JefferyLim/floppy/finalReport/images/BOT.jpg

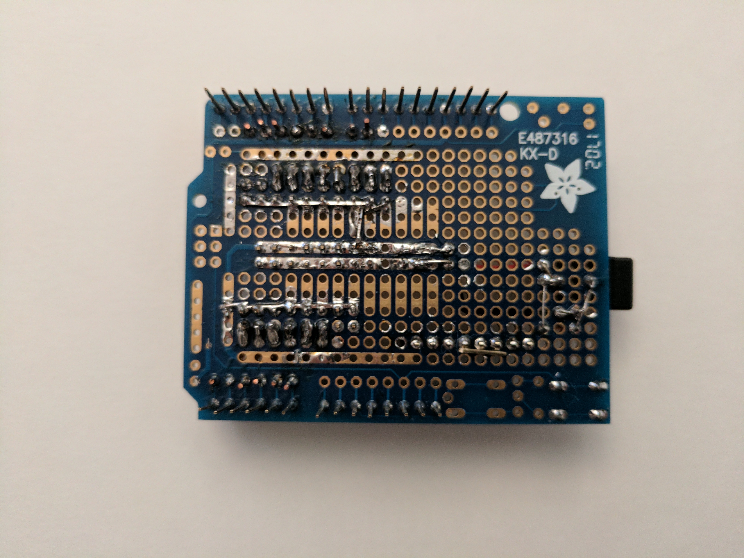
finalReport/images/BOT.jpg
