JefferyLim/floppy/finalReport/images/power_wire.jpg

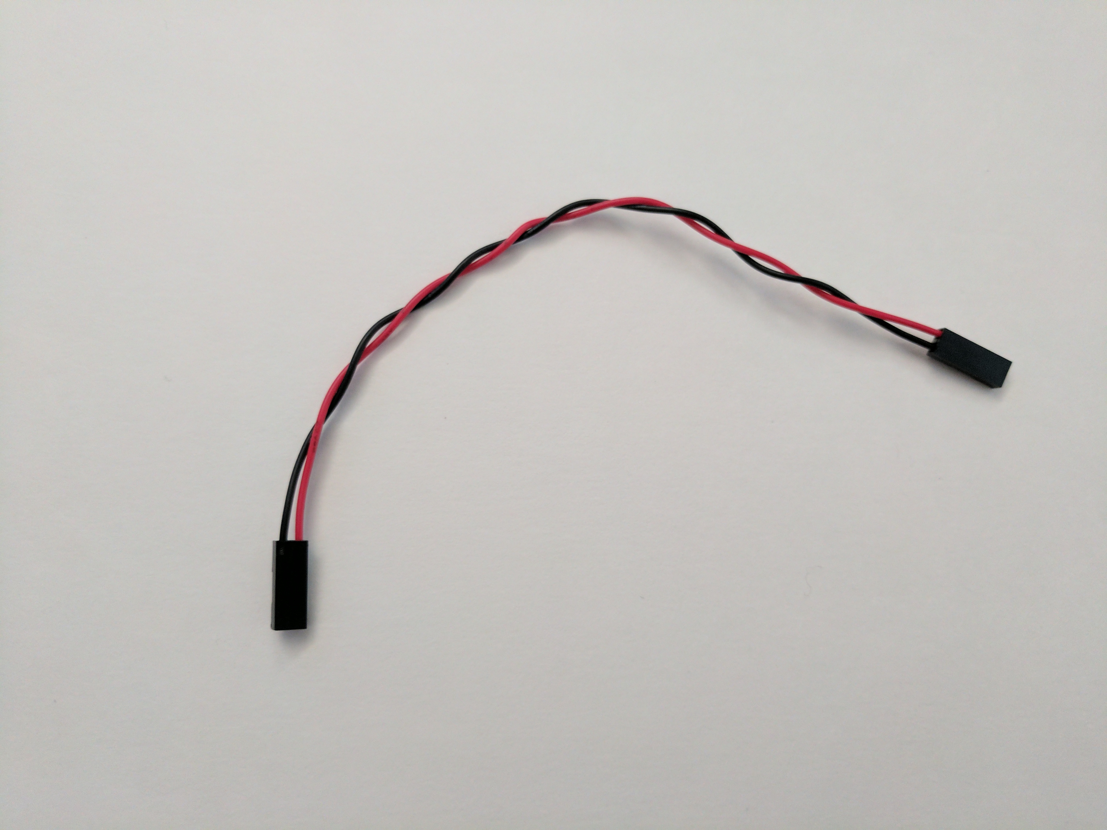
finalReport/images/power_wire.jpg
