JefferyLim/floppy/(commit log)

2017-03-03 Finished software, added new drivers, started report
2017-04-03 Fixed file inconsistencies and added music
    [ardumidi_test.pde, ardumidi_test_all_instruments.pde, from_alsa_to_arduino.pde]
